bluelineXY/plinky_public/hw/v3-wm8904/models/TYPE-C-31-M-12--3DModel-STEP-56544.STEP

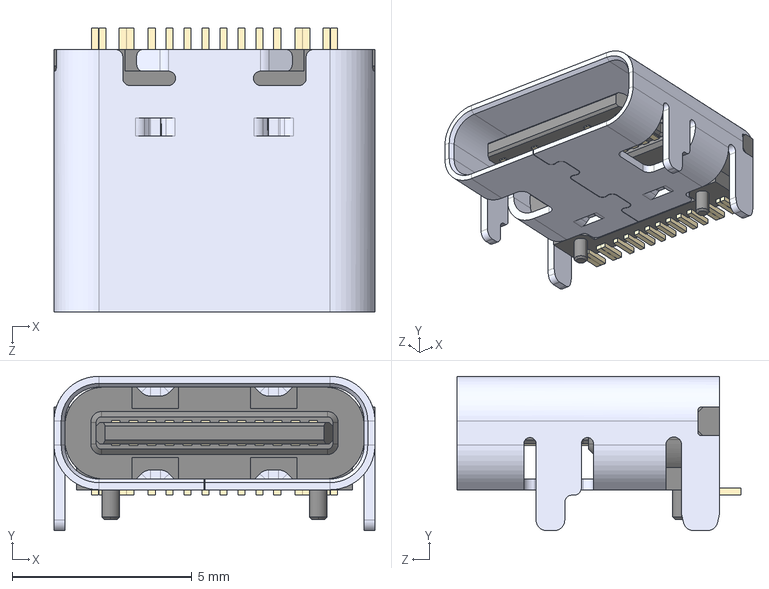
[picture p1: CAD file, 2024-08-06]
hw/v3-wm8904/models/TYPE-C-31-M-12--3DModel-STEP-56544.STEP
8.94 x 4.30 x 7.90 mm
